jaepun1/jaepun1/(commit log)

2026-11-11 Add pill dispenser firmware, web app and simulator
    - main_board: ESP32 firmware (schedule from web, dispense, alarm with
    reminders, IR pill detection, OLED) + extended Wokwi circuit
    - esp32s3_cam: Wi-Fi/WebSocket bridge to the main board and camera
    (photo when dispensed and after taken)
    - webapp: show both photos per slot; keep each date on a fixed floor
    - simulator: Node device simulator for testing the web app
    Claude-Session: https://claude.ai/code/session_01G9U7ffjWw3kweqnpvyxTnw
    [esp32s3_cam.ino, main_board.ino, sketch.ino]
2026-11-12 Set camera board to ESP32-S3 N16R8 CAM (OV2640)
    Document the Arduino IDE settings for the 16MB flash / 8MB OPI PSRAM
    board and which USB port to use.
    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
2026-11-12 Use EC-BOT PU analog sensor for pill detection
    Read the line-follower sensor on GPIO36 (ADC1) with averaging, a
    configurable threshold and hysteresis; report the raw value in status
    and via the new {"cmd":"ir"} command for calibration. Replace the
    Wokwi slide switch with a potentiometer and document mounting and
    calibration.
    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
    [main_board.ino]
2026-11-12 Add machine test, camera test and command box to SETTING
    - main_board: new test mode ({"cmd":"test"}) that runs a full dose
    cycle and reports each step, plus {"cmd":"cancel"}; test and manual
    dispenses no longer mark the schedule or overwrite dose photos
    - esp32s3_cam: pass the capture phase through and report photo_error
    - webapp: SETTING tab gets a step-by-step test checklist with live
    sensor value and test photos, a camera test button, and a command box
    - simulator: support test/cancel/ir and NO_PILL / CAM_FAIL scenarios
    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
    [esp32s3_cam.ino, main_board.ino]
2026-11-12 Fix build: rename dose enums that clash with ESP32 core
    PENDING is already declared by esp_rom's ets_sys.h; prefix the dose
    state and mode values with DOSE_.
    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
    [main_board.ino]
2026-11-12 Wokwi: start the pill sensor knob at 'empty tray' and move its label
    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
2026-11-12 Wokwi: use a slide switch to simulate the analog pill sensor
    The potentiometer was hard to turn in the simulator. The switch feeds
    3.3V (empty) or GND (pill) into GPIO36, so the analog code path is
    still exercised.
    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
2026-11-13 Get time from the internet via the camera board
    - esp32s3_cam: sync Thailand time over NTP and send it to the main
    board on boot and every 10 minutes
    - main_board: work with DS1307 or DS3231 unchanged, fall back to the
    board's own clock when no RTC is found, only adjust on NTP drift,
    and hold scheduled doses until the time is known
    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
    [esp32s3_cam.ino, main_board.ino]
